xtremespb/minifrank/3D/SJ1-3535NG.stp

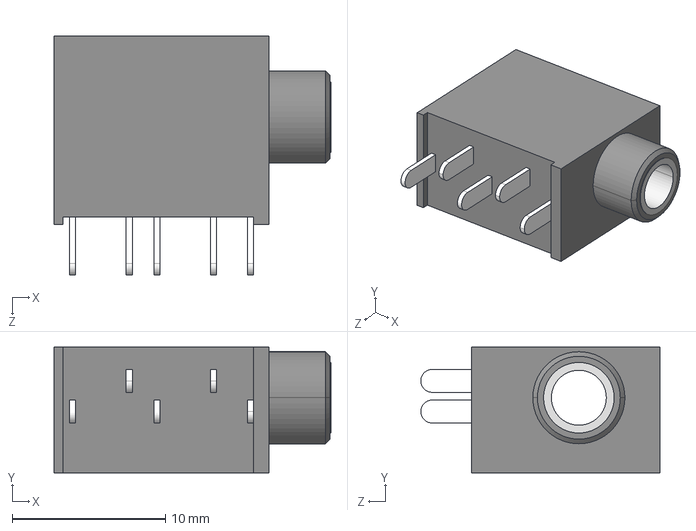
[picture p1: CAD file, 2024-09-16]
3D/SJ1-3535NG.stp
18.1 x 8.20 x 15.6 mm
