xtremespb/minifrank/case/bottom.stl

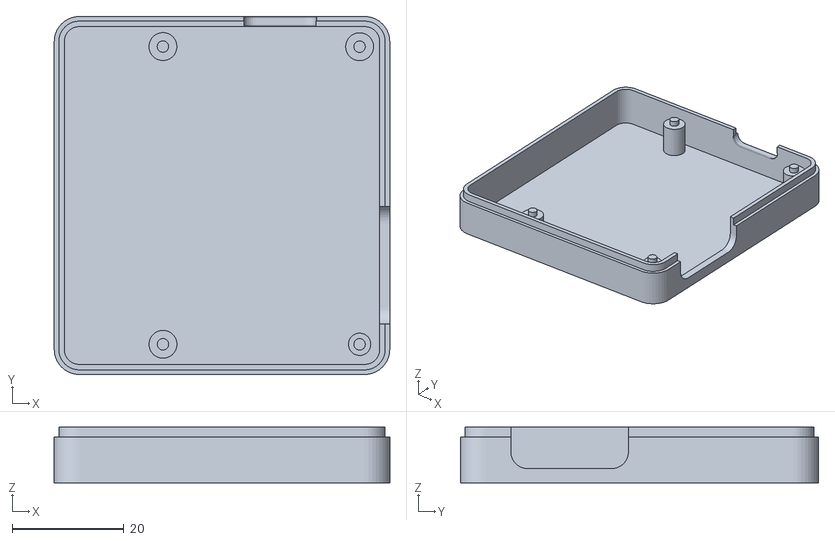
[picture p2: CAD file, 2024-11-18]
case/bottom.stl
60.0 x 64.0 x 10.00
