xtremespb/minifrank/3D/Mini-DIN-6P.step

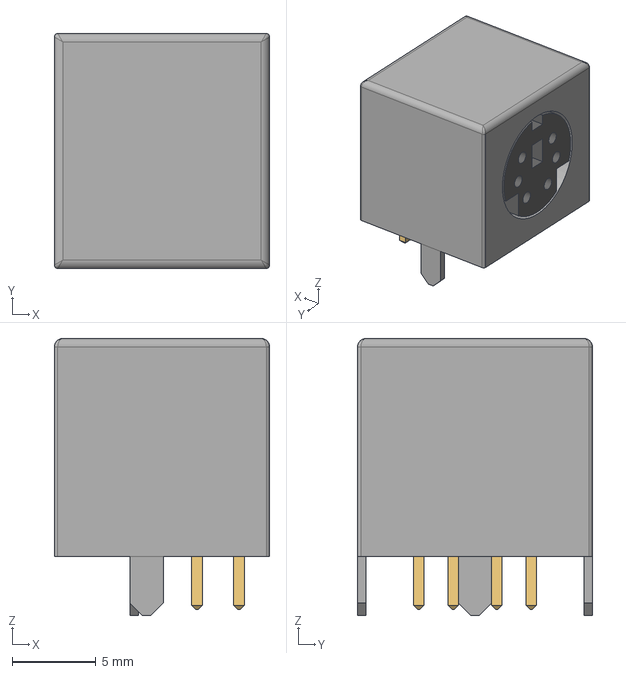
[picture p3: CAD file, 2024-09-16]
3D/Mini-DIN-6P.step
12.8 x 14.0 x 16.5 mm
