xtremespb/minifrank/case/top.stl

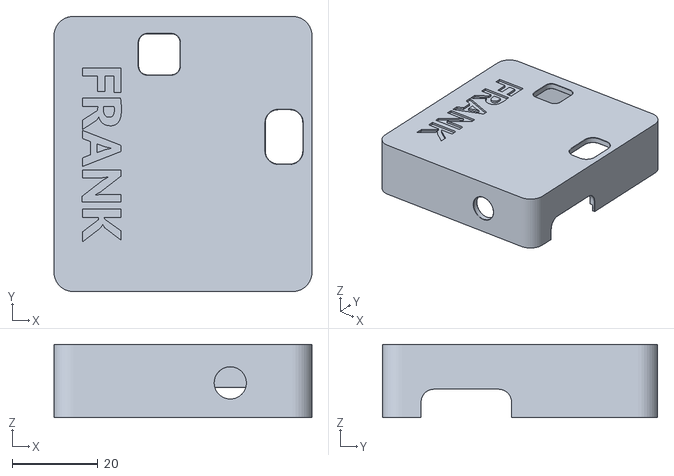
[picture p4: CAD file, 2024-11-18]
case/top.stl
60.0 x 64.0 x 17.0
