xtremespb/minifrank/3D/HRO_TYPE-C-31-M-12.step

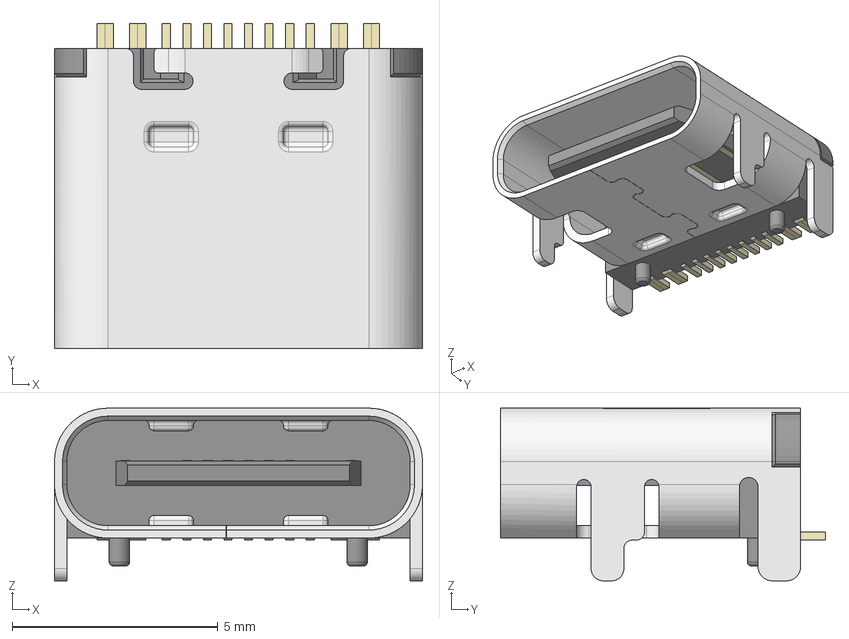
[picture p6: CAD file, 2024-09-16]
3D/HRO_TYPE-C-31-M-12.step
8.95 x 7.90 x 4.20 mm
