xtremespb/minifrank/minifrank.kicad_pcb

## KiCad design minifrank.kicad_pcb (2024-12-14)

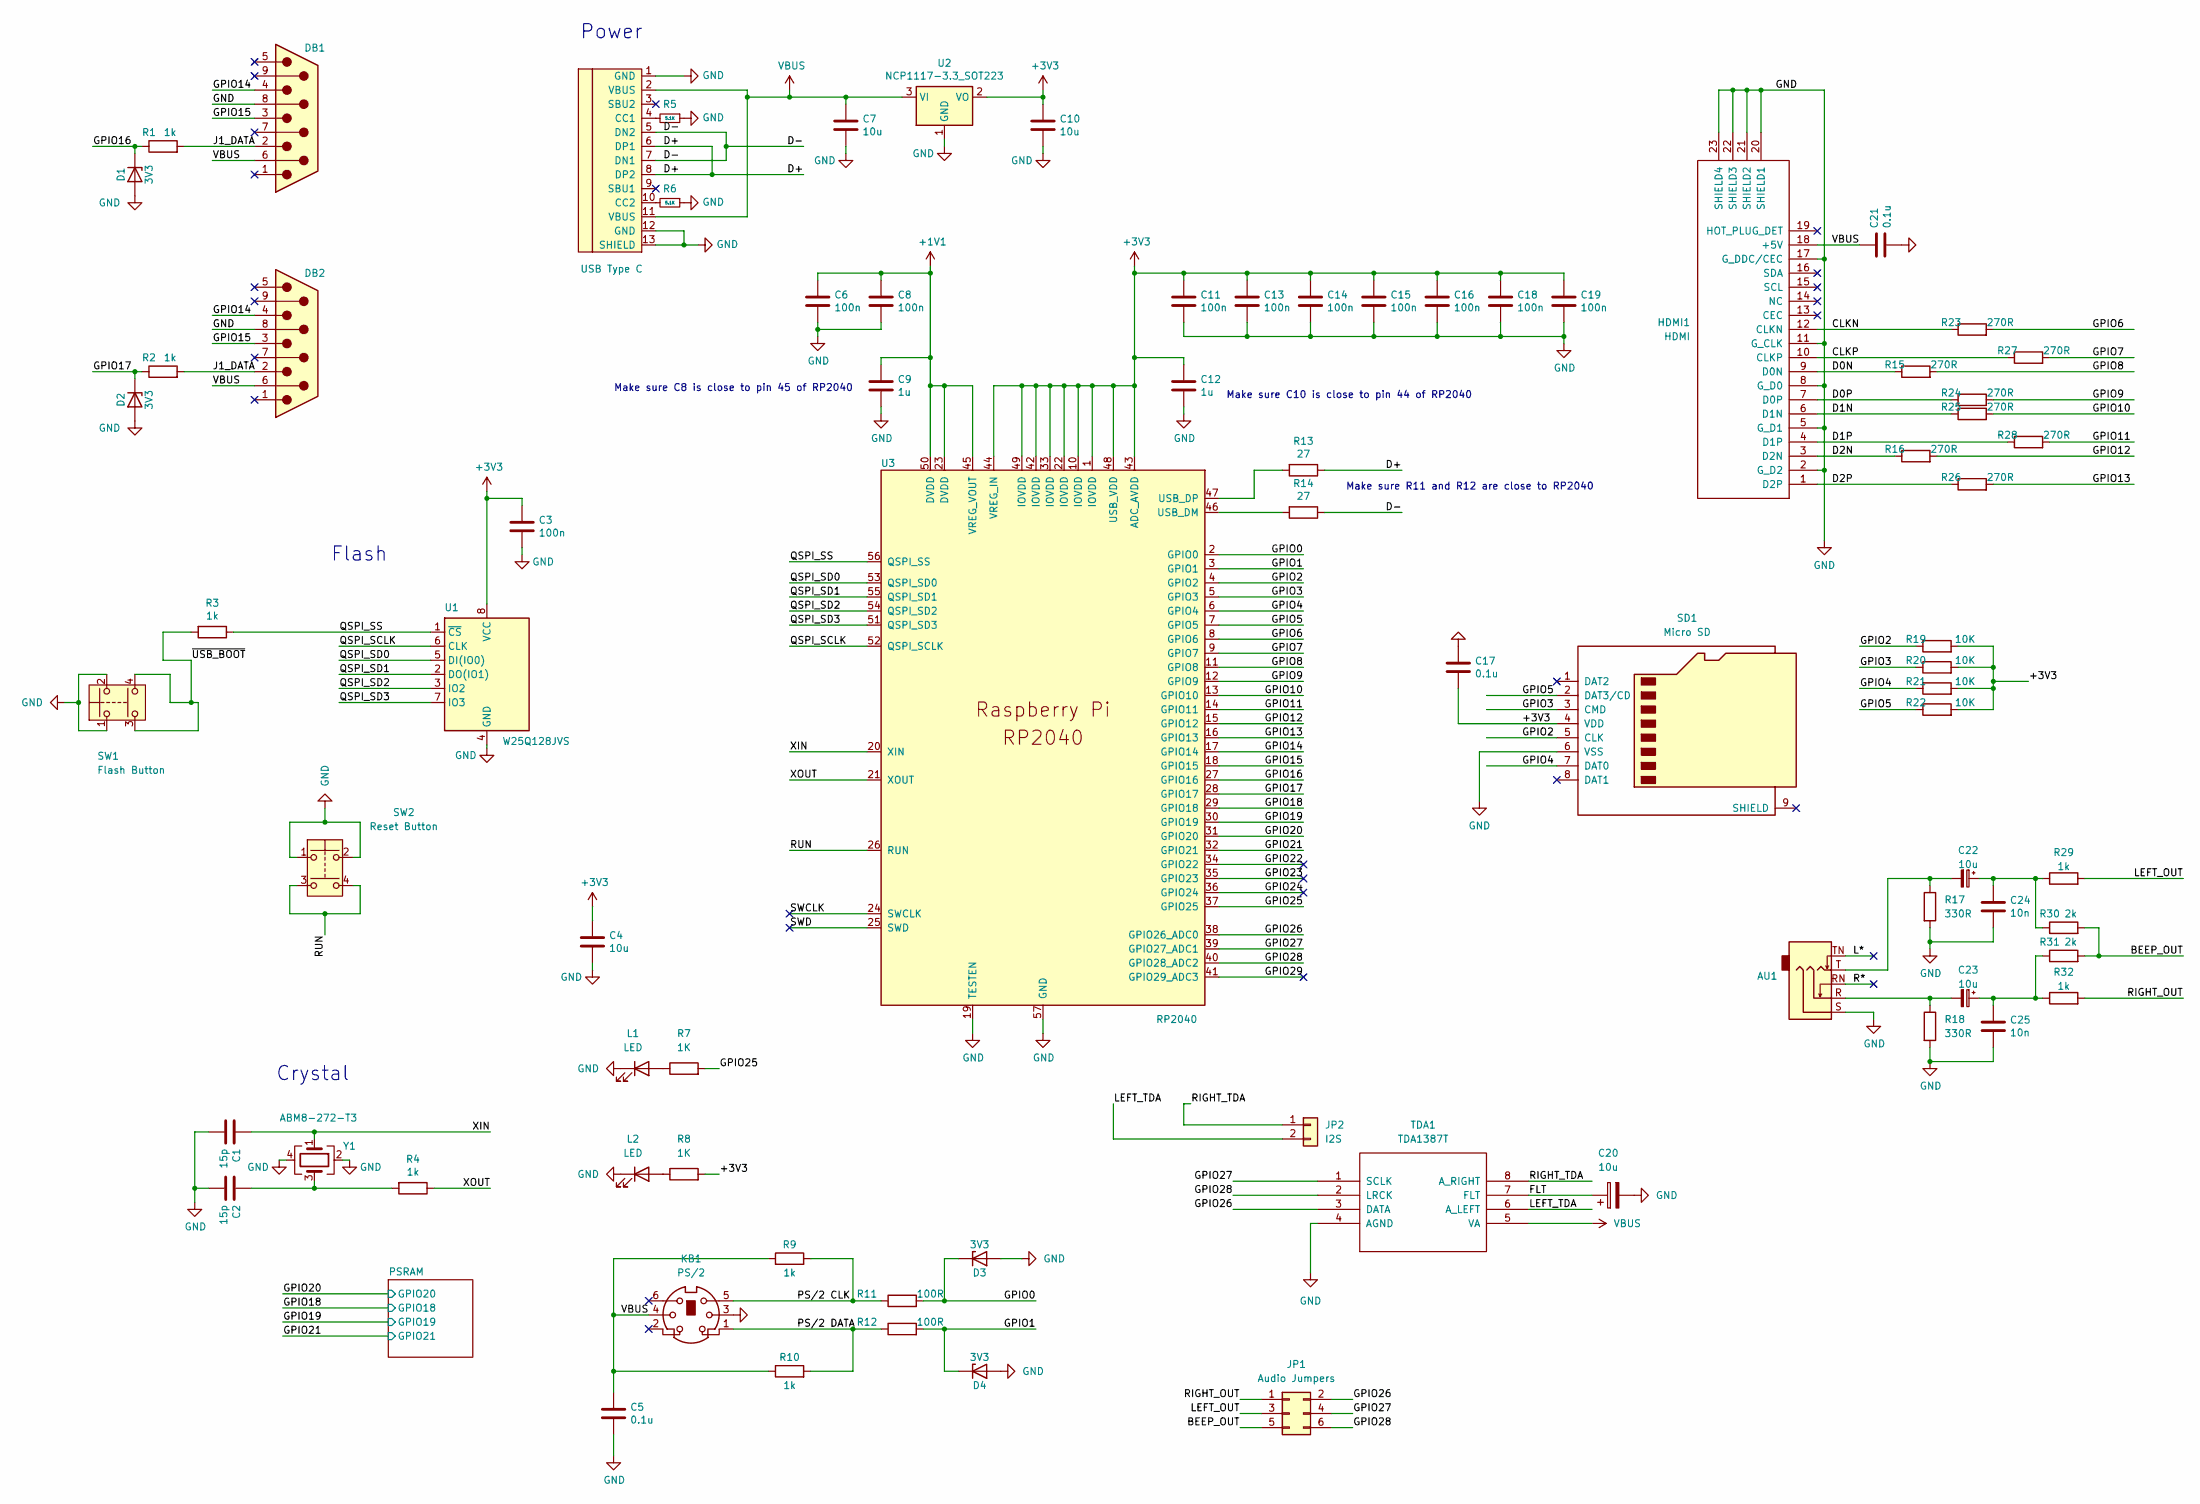
[picture p9: schematic minifrank.kicad_sch, Mini FRANK]

Parts:
AU1: AUDIO OUT; Medved_Jack_3.5mm_CUI_SJ1-3535NG_Horizontal
C1, C2: 15p; Medved_C_0805
C3, C6, C8, C11, C13, C14, C15, C16, C18, C19: 100n; Medved_C_0805
C4, C7, C10, C22, C23: 10u; Medved_C_0805
C5, C17, C21: 0.1u; Medved_C_0805
C9, C12: 1u; Medved_C_0805
C20: 10u; Medved_CP_Radial_D5.0mm_P2.50mm
C24, C25: 10n; Medved_C_0805
D1, D2, D3, D4: 3V3; Medved_D_0805
DB1, DB2: Joystick; DSUB-9_Male_EdgeMount_P2.77mm
HDMI1: HDMI
JP1: Audio Jumpers; Medved_JMP_2x03
JP2: I2S; Medved_PinHeader_1x02
KB1: PS/2; Connector_Mini-DIN_Female_6Pin_2rows
L1, L2: LED; LED_0805_2012Metric_Pad1.15x1.40mm_HandSolder
R1, R2, R3, R4, R9, R10, R29, R32: 1k; Medved_R_0805
R5, R6: 5.1K; Medved_R_0805
R7, R8: 1K; Medved_R_0805
R11, R12: 100R; Medved_R_0805
R13, R14: 27; Medved_R_0805
R15, R16, R23, R24, R25, R26, R27, R28: 270R; Medved_R_0805
R17, R18: 330R; Medved_R_0805
R19, R20, R21, R22: 10K; Medved_R_0805
R30, R31: 2k; Medved_R_0805
SD1: Micro SD; Medved_SD_Card
SW1: Flash Button; Button_SMD_3x3x2
SW2: Reset Button; Button_SMD_3x3x2
TDA1: TDA1387T; SO-8_5.3x6.2mm_P1.27mm
U1: W25Q128JVS; SOIC-8_5.23x5.23mm_P1.27mm
U2: NCP1117-3.3_SOT223; SOT-223-3_TabPin2
U3: RP2040; RP2040-QFN-56
USB1: USB Type C; USB-TYPE-C-31-M-12_lib2; LCSC C165948
Y1: ABM8-272-T3; Crystal_SMD_3225-4Pin_3.2x2.5mm

Connections:
+1V1: C6.1, C8.1, C9.1, U3.23 (DVDD), U3.45 (VREG_VOUT), U3.50 (DVDD)
+3V3: C3.1, C4.1, C10.1, C11.1, C12.1, C13.1, C14.1, C15.1, C16.1, C17.2, C18.1, C19.1, R8.2, R19.2, R20.2, R21.2, R22.2, SD1.4 (VDD), U1.8 (VCC), U2.2 (VO), U3.1 (IOVDD), U3.10 (IOVDD), U3.22 (IOVDD), U3.33 (IOVDD), U3.42 (IOVDD), U3.43 (ADC_AVDD), U3.44 (VREG_IN), U3.48 (USB_VDD), U3.49 (IOVDD); also elsewhere on the board
/BEEP_OUT: JP1.5, R30.2, R31.2
/CLKN: HDMI1.12 (CLKN), R23.1
/CLKP: HDMI1.10 (CLKP), R27.1
/D0N: HDMI1.9 (D0N), R15.1
/D0P: HDMI1.7 (D0P), R24.1
/D1N: HDMI1.6 (D1N), R25.1
/D1P: HDMI1.4 (D1P), R28.1
/D2N: HDMI1.3 (D2N), R16.1
/D2P: HDMI1.1 (D2P), R26.1
/D+: R13.1, USB1.6 (DP1), USB1.8 (DP2)
/D-: R14.1, USB1.5 (DN2), USB1.7 (DN1)
/FLT: C20.1, TDA1.7 (FLT)
/GPIO0: D3.1 (K), R11.2, U3.2 (GPIO0)
/GPIO1: D4.1 (K), R12.2, U3.3 (GPIO1)
/GPIO2: R19.1, SD1.5 (CLK), U3.4 (GPIO2)
/GPIO3: R20.1, SD1.3 (CMD), U3.5 (GPIO3)
/GPIO4: R21.1, SD1.7 (DAT0), U3.6 (GPIO4)
/GPIO5: R22.1, SD1.2 (DAT3/CD), U3.7 (GPIO5)
/GPIO6: R23.2, U3.8 (GPIO6)
/GPIO7: R27.2, U3.9 (GPIO7)
/GPIO8: R15.2, U3.11 (GPIO8)
/GPIO9: R24.2, U3.12 (GPIO9)
/GPIO10: R25.2, U3.13 (GPIO10)
/GPIO11: R28.2, U3.14 (GPIO11)
/GPIO12: R16.2, U3.15 (GPIO12)
/GPIO13: R26.2, U3.16 (GPIO13)
/GPIO14: DB1.4, DB2.4, U3.17 (GPIO14)
/GPIO15: DB1.3, DB2.3, U3.18 (GPIO15)
/GPIO16: D1.1 (K), R1.1, U3.27 (GPIO16)
/GPIO17: D2.1 (K), R2.1, U3.28 (GPIO17)
/GPIO18: U3.29 (GPIO18); also elsewhere on the board
/GPIO19: U3.30 (GPIO19); also elsewhere on the board
/GPIO20: U3.31 (GPIO20); also elsewhere on the board
/GPIO21: U3.32 (GPIO21); also elsewhere on the board
/GPIO22: U3.34 (GPIO22)
/GPIO23: U3.35 (GPIO23)
/GPIO24: U3.36 (GPIO24)
/GPIO25: R7.2, U3.37 (GPIO25)
/GPIO26: JP1.2, TDA1.3 (DATA), U3.38 (GPIO26_ADC0)
/GPIO27: JP1.4, TDA1.1 (SCLK), U3.39 (GPIO27_ADC1)
/GPIO28: JP1.6, TDA1.2 (LRCK), U3.40 (GPIO28_ADC2)
/GPIO29: U3.41 (GPIO29_ADC3)
/J1_DATA: DB1.2, DB2.2, R1.2, R2.2
/L*: AU1.TN
/LEFT_OUT: JP1.3, R29.2
/LEFT_TDA: JP2.2, TDA1.6 (A_LEFT)
/PS/2 CLK: KB1.5, R9.2, R11.1
/PS/2 DATA: KB1.1, R10.2, R12.1
/QSPI_SCLK: U1.6 (CLK), U3.52 (QSPI_SCLK)
/QSPI_SD0: U1.5 (DI(IO0)), U3.53 (QSPI_SD0)
/QSPI_SD1: U1.2 (DO(IO1)), U3.55 (QSPI_SD1)
/QSPI_SD2: U1.3 (IO2), U3.54 (QSPI_SD2)
/QSPI_SD3: U1.7 (IO3), U3.51 (QSPI_SD3)
/QSPI_SS: R3.1, U1.1 (~CS), U3.56 (QSPI_SS)
/R*: AU1.RN
/RIGHT_OUT: JP1.1, R32.2
/RIGHT_TDA: JP2.1, TDA1.8 (A_RIGHT)
/RUN: SW2.3, SW2.4, U3.26 (RUN)
/SWCLK: U3.24 (SWCLK)
/SWD: U3.25 (SWD)
/XIN: C1.1, U3.20 (XIN), Y1.1
/XOUT: R4.1, U3.21 (XOUT)
/~USB_BOOT: R3.2, SW1.3, SW1.4
GND: AU1.S, C1.2, C2.2, C3.2, C4.2, C5.2, C6.2, C7.2, C8.2, C9.2, C10.2, C11.2, C12.2, C13.2, C14.2, C15.2, C16.2, C17.1, C18.2, C19.2, C20.2, C21.2, C24.2, C25.2, D1.2 (A), D2.2 (A), D3.2 (A), D4.2 (A), DB1.8, DB2.8, HDMI1.2 (G_D2), HDMI1.5 (G_D1), HDMI1.8 (G_D0), HDMI1.11 (G_CLK), HDMI1.17 (G_DDC/CEC), HDMI1.20 (SHIELD1), HDMI1.21 (SHIELD2), HDMI1.22 (SHIELD3), HDMI1.23 (SHIELD4), KB1.3, L1.1 (K), L2.1 (K), R5.1, R6.1, R17.2, R18.2, SD1.6 (VSS), SW1.1, SW1.2, SW2.1, SW2.2, TDA1.4 (AGND), U1.4 (GND), U2.1 (GND), U3.19 (TESTEN), U3.57 (GND), USB1.1 (GND), USB1.12 (GND), USB1.13 (SHIELD), Y1.2, Y1.4; also elsewhere on the board
unnamed: AU1.R, C23.2, R18.1
unnamed: AU1.T, C22.2, R17.1
unnamed: C2.1, R4.2, Y1.3
unnamed: C22.1, C24.1, R29.1, R30.1
unnamed: C23.1, C25.1, R31.1, R32.1
unnamed: L1.2 (A), R7.1
unnamed: L2.2 (A), R8.1
unnamed: R14.2, U3.46 (USB_DM)
unnamed: R13.2, U3.47 (USB_DP)
unnamed: R5.2, USB1.4 (CC1)
unnamed: R6.2, USB1.10 (CC2)
VBUS: C5.1, C7.1, C21.1, DB1.6, DB2.6, HDMI1.18 (+5V), KB1.4, R9.1, R10.1, TDA1.5 (VA), U2.3 (VI), USB1.2 (VBUS), USB1.11 (VBUS)

Notes on the sheet:
Power
Crystal
Make sure C8 is close to pin 45 of RP2040
Make sure C10 is close to pin 44 of RP2040
Make sure R11 and R12 are close to RP2040
Flash

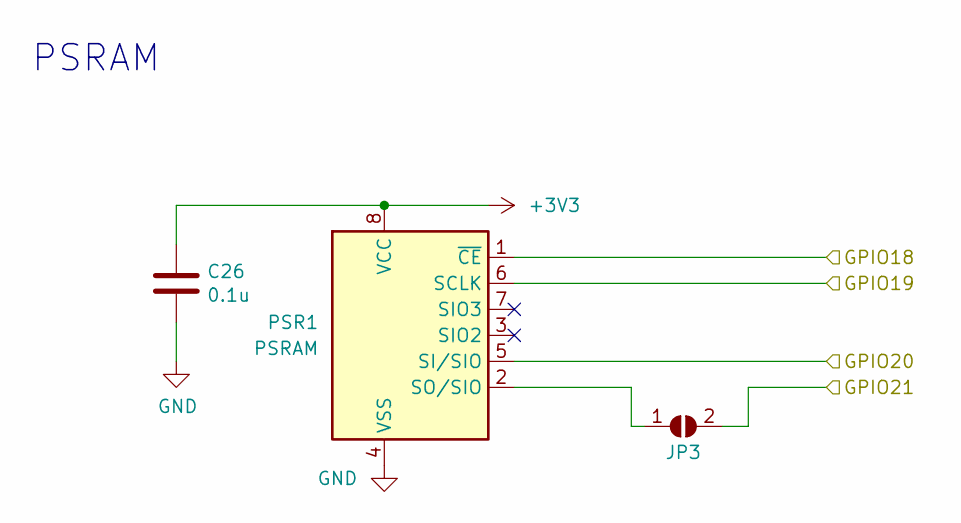
[picture p10: schematic psram.kicad_sch, Mini FRANK]

Parts:
C26: 0.1u; C_0805_2012Metric_Pad1.18x1.45mm_HandSolder
JP3: JMP PSRAM; SolderJumper-2_P1.3mm_Open_RoundedPad1.0x1.5mm
PSR1: PSRAM; SO-8_5.3x6.2mm_P1.27mm

Connections:
+3V3: C26.1, PSR1.8 (VCC); also elsewhere on the board
/GPIO18: PSR1.1 (~CE); also elsewhere on the board
/GPIO19: PSR1.6 (SCLK); also elsewhere on the board
/GPIO20: PSR1.5 (SI/SIO); also elsewhere on the board
/GPIO21: JP3.2 (B); also elsewhere on the board
GND: C26.2, PSR1.4 (VSS); also elsewhere on the board
unnamed: JP3.1 (A), PSR1.2 (SO/SIO)

Notes on the sheet:
PSRAM

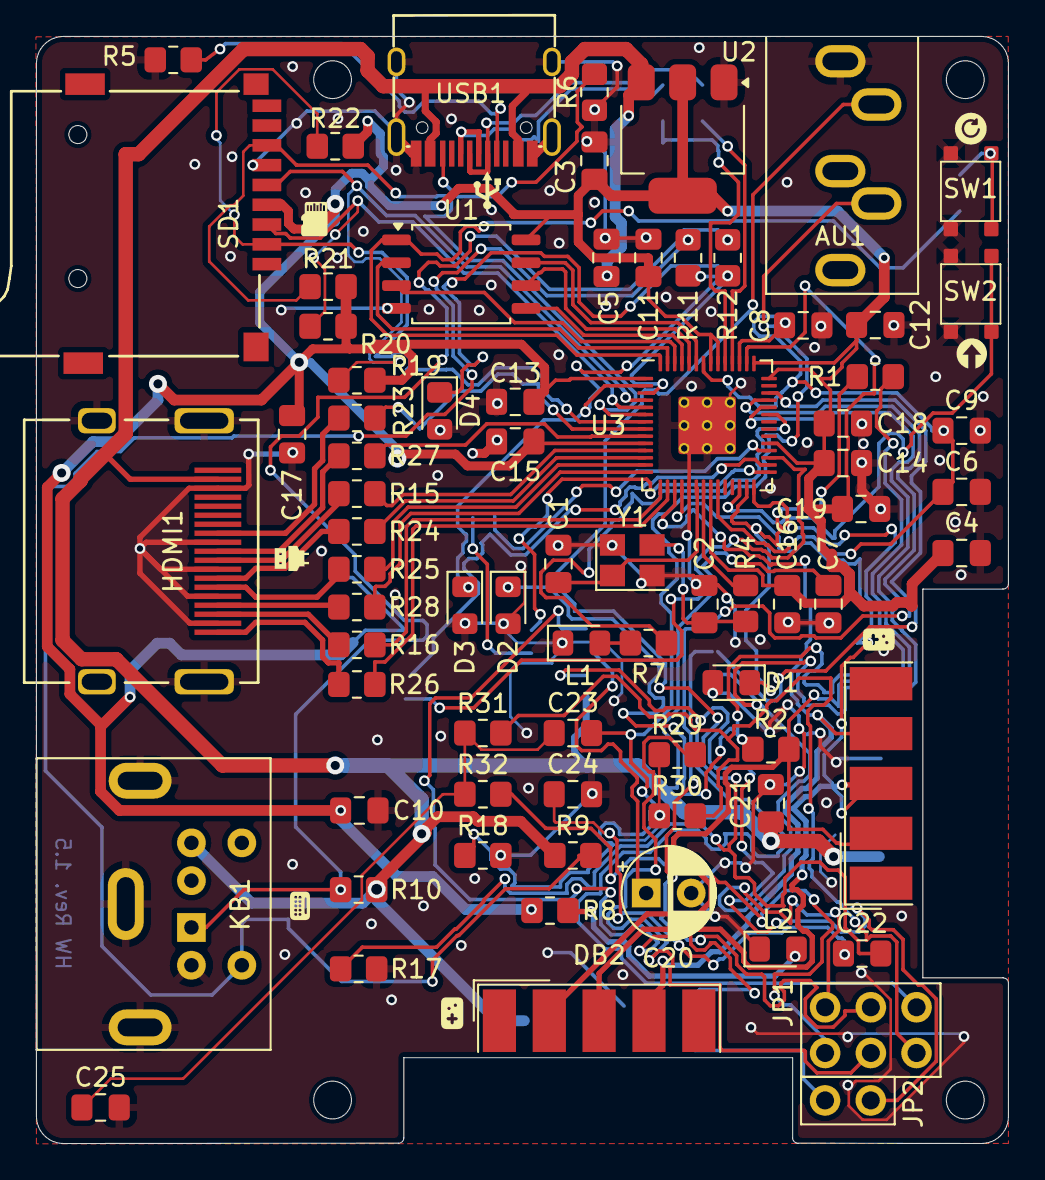
[picture p11: board minifrank.kicad_pcb from above]

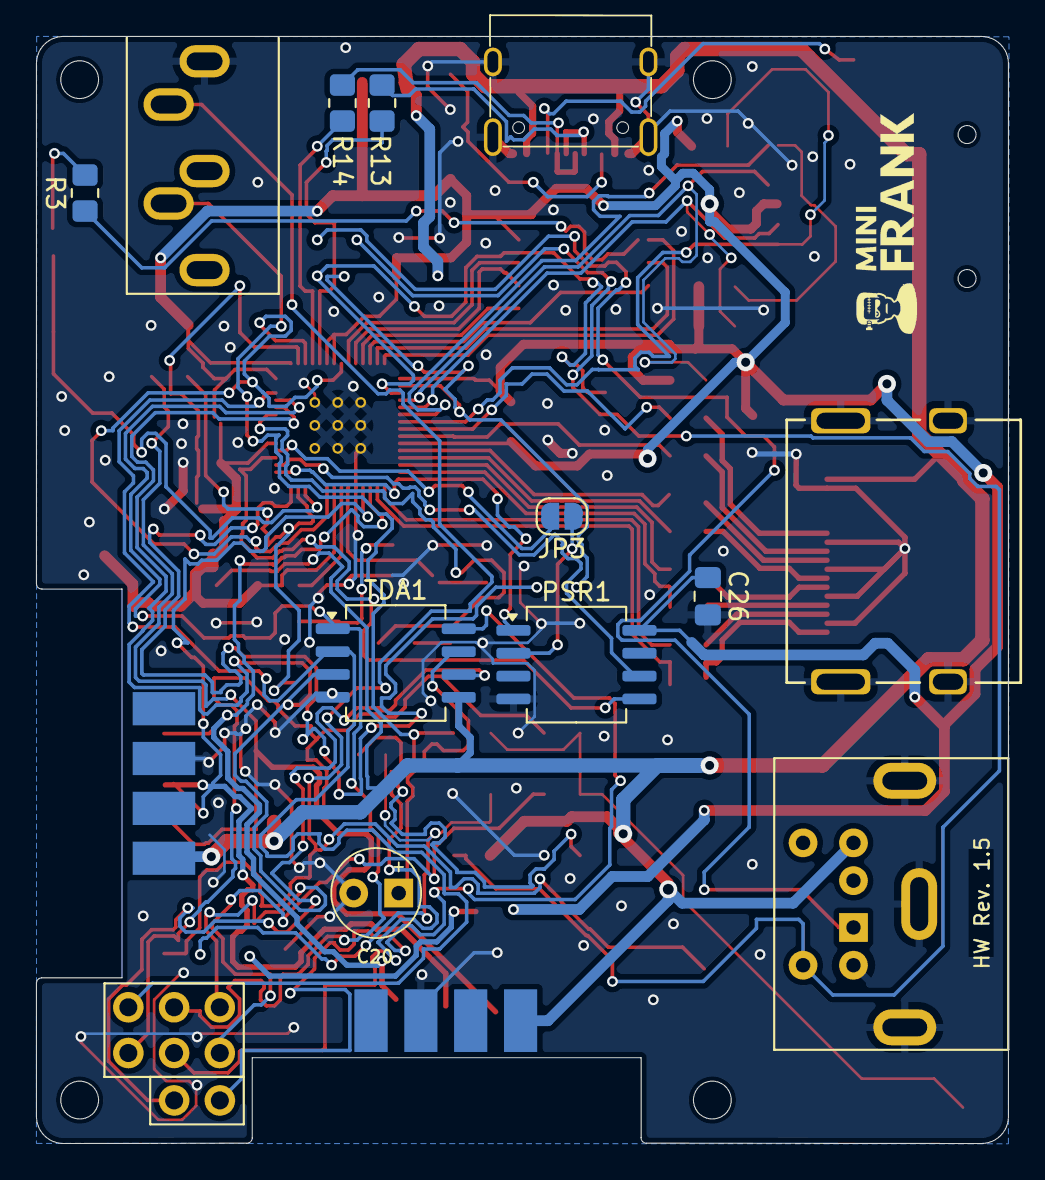
[picture p12: board minifrank.kicad_pcb from below]

Board: 2 copper layers, 54.0 x 61.5 mm, 82 parts (7 on the bottom side), 71 nets.
