xtremespb/minifrank/(commit log)

2024-09-17 HW Rev 1.0
    [minifrank.kicad_pcb, minifrank.kicad_sch]
2024-09-17 HW Rev. 1.0 (final)
    [minifrank.kicad_pcb, minifrank.kicad_sch]
2024-09-17 Minor updates
    [minifrank.kicad_pcb]
2024-09-17 Minor fixes
    [minifrank.kicad_pcb]
2024-10-23 HW Rev 1.1
    [minifrank.kicad_pcb, minifrank.kicad_sch]
2024-11-13 HW Rev. 1.2
    [minifrank.kicad_pcb, minifrank.kicad_sch]
2024-11-27 HW Rev 1.3
    [minifrank.kicad_pcb, minifrank.kicad_sch]
2024-11-27 HW Rev 1.4
    [minifrank.kicad_pcb, minifrank.kicad_sch, psram.kicad_sch]
2024-11-28 Updates to HW Rev 1.4
    [minifrank.kicad_pcb, minifrank.kicad_sch, psram.kicad_sch]
2024-12-13 HW Rev 1.5
    [audio.kicad_sch, minifrank.kicad_pcb, minifrank.kicad_sch, psram.kicad_sch]
